kentdev/RGB-LEDs/README.md

# RGB-LEDs
Controls for a strip of Radioshack tricolor LEDs
