kentdev/RGB-LEDs/modeling/Control Board + Enclosure.fcstd

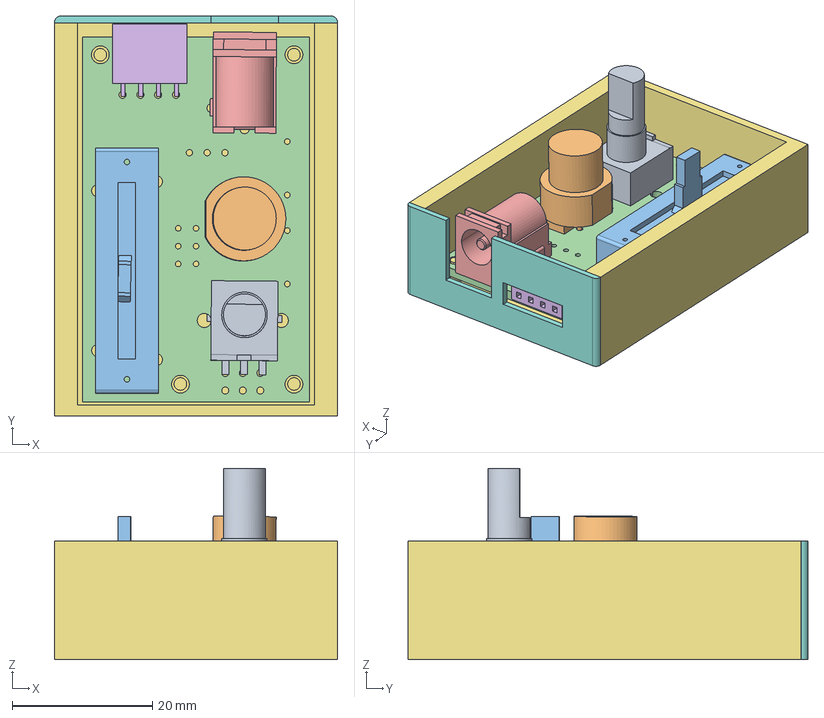
[picture p1: CAD file, 2015-12-07]
modeling/Control Board + Enclosure.fcstd
40.4 x 57.1 x 27.3 mm
Rotary
Button
Slide
Board_outline
PJ-202A
4-pin header
