kentdev/RGB-LEDs/modeling/4-pin header.fcstd

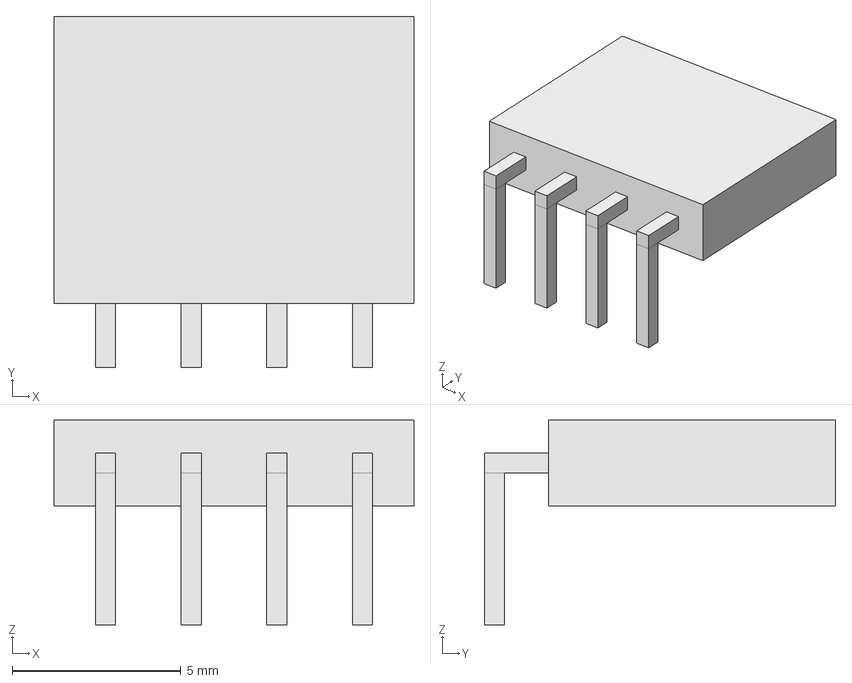
[picture p2: CAD file, 2015-09-26]
modeling/4-pin header.fcstd
10.7 x 10.4 x 6.07 mm
