kentdev/RGB-LEDs/modeling/Control board.fcstd

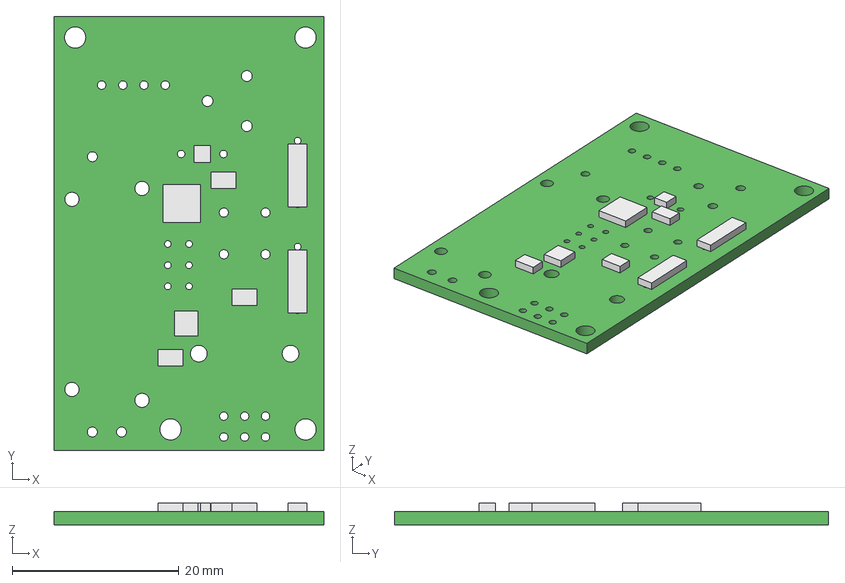
[picture p3: CAD file, 2015-09-26]
modeling/Control board.fcstd
32.4 x 52.1 x 2.60 mm
Board_outline
C1
C2
C3
IC2
R1
R3
REG1
RES1
