kentdev/RGB-LEDs/modeling/Controls.fcstd

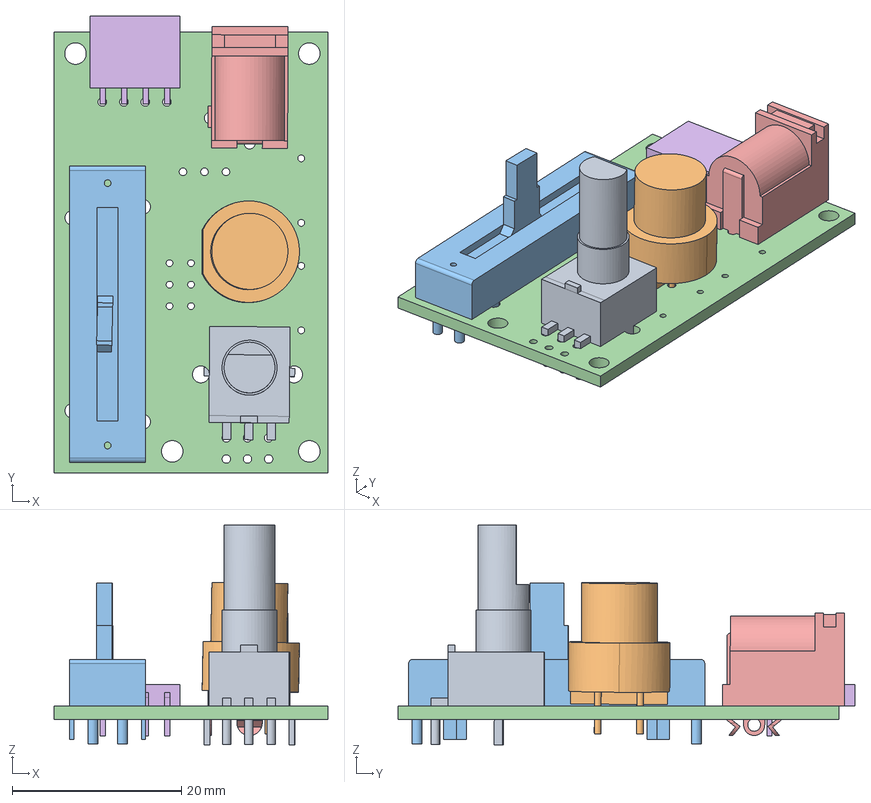
[picture p4: CAD file, 2015-09-26]
modeling/Controls.fcstd
32.4 x 53.9 x 26.0 mm
Rotary
Button
Slide
Board_outline
PJ-202A
4-pin header
