kentdev/RGB-LEDs/modeling/PJ-202A.stp

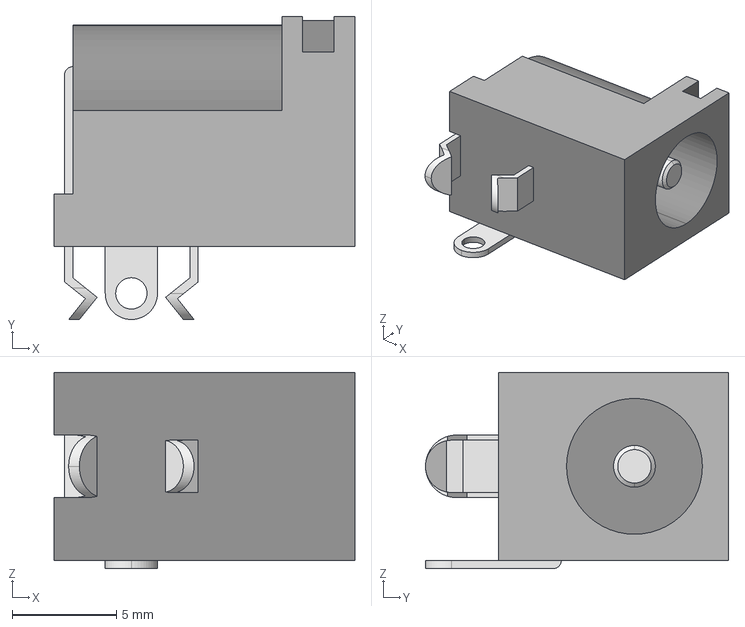
[picture p5: CAD file, 2015-09-26]
modeling/PJ-202A.stp
14.4 x 14.5 x 9.40 mm
