kentdev/RGB-LEDs/modeling/PTA2043 Linear Potentiometer.fcstd

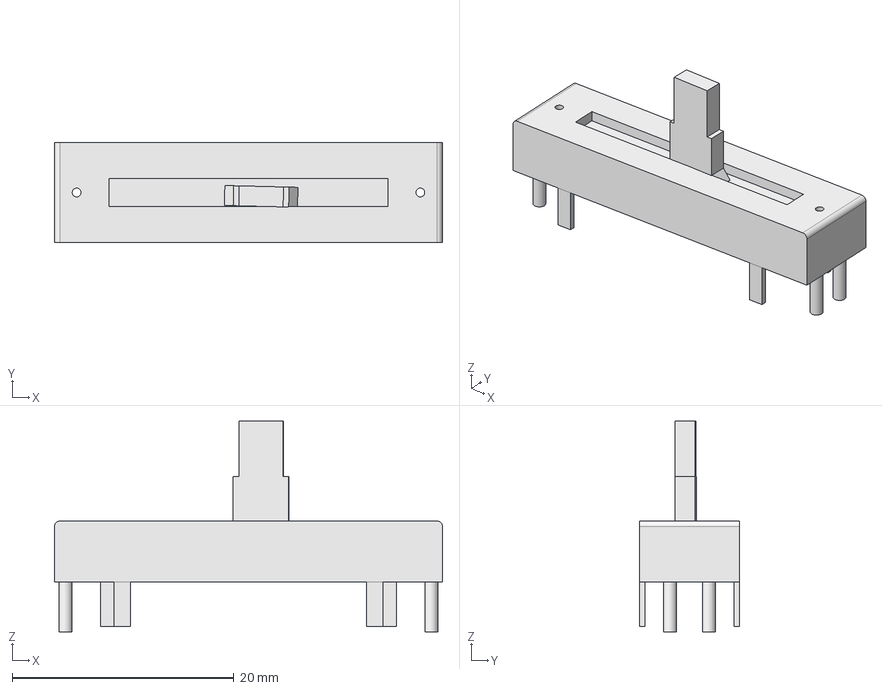
[picture p6: CAD file, 2015-08-29]
modeling/PTA2043 Linear Potentiometer.fcstd
35.0 x 9.00 x 19.0 mm
