kentdev/RGB-LEDs/modeling/PTA1543-2010CI slide potentiometer.fcstd

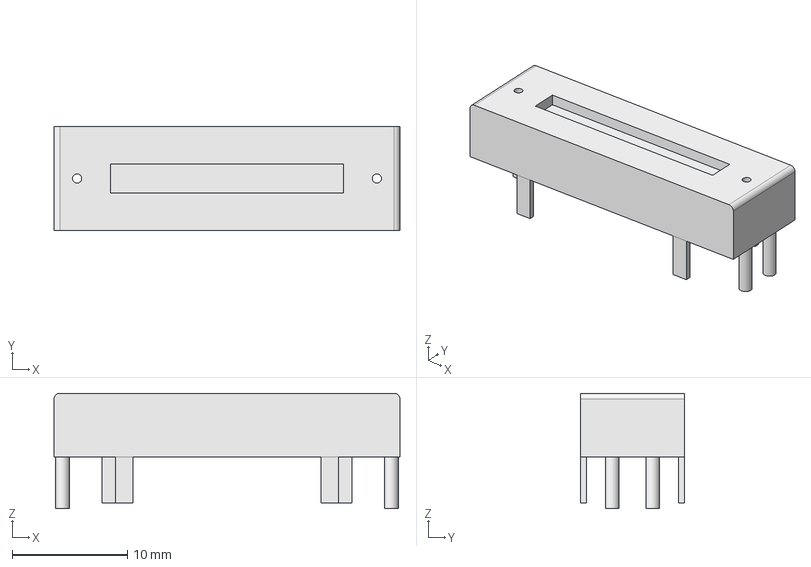
[picture p7: CAD file, 2015-08-29]
modeling/PTA1543-2010CI slide potentiometer.fcstd
30.0 x 9.00 x 10.0 mm
