kentdev/RGB-LEDs/modeling/PTA1543-2010CI Linear Potentiometer.fcstd

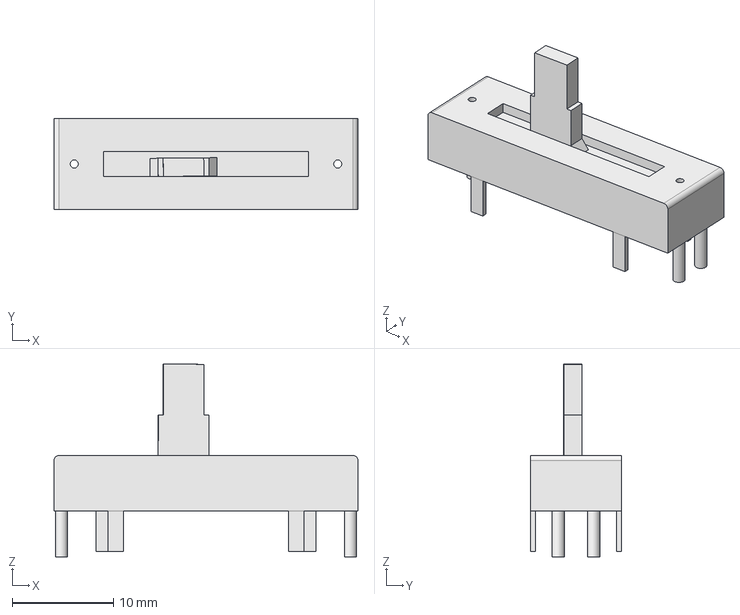
[picture p8: CAD file, 2015-08-29]
modeling/PTA1543-2010CI Linear Potentiometer.fcstd
30.0 x 9.00 x 19.0 mm
