kentdev/RGB-LEDs/modeling/LM7805c.fcstd

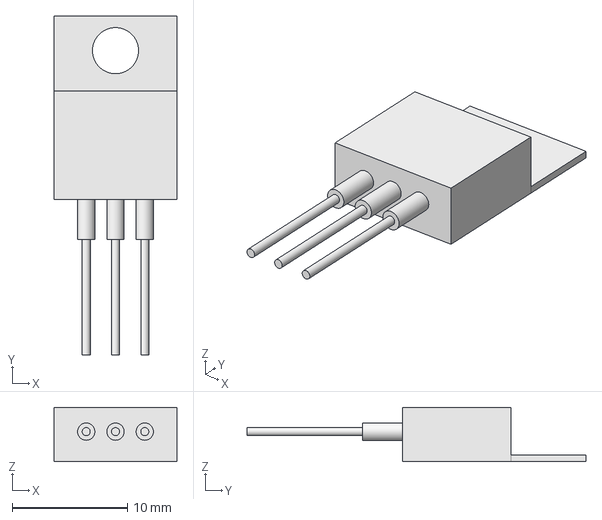
[picture p9: CAD file, 2015-08-29]
modeling/LM7805c.fcstd
10.7 x 29.4 x 4.70 mm
