kentdev/RGB-LEDs/modeling/PTA1543-2010CI slide lever.fcstd

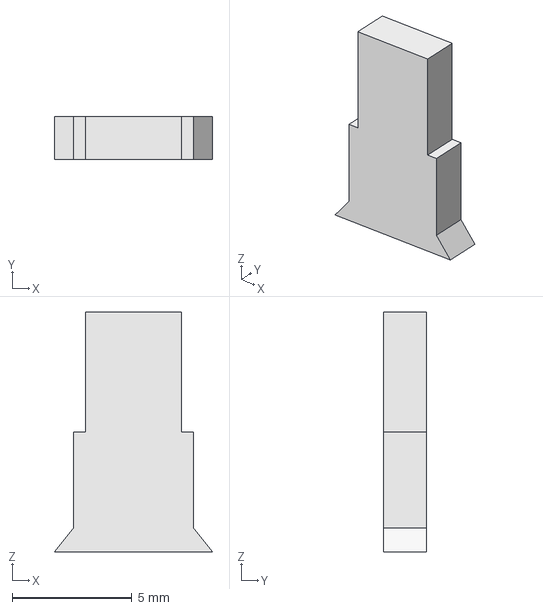
[picture p10: CAD file, 2015-08-23]
modeling/PTA1543-2010CI slide lever.fcstd
6.60 x 1.80 x 10.0 mm
