kentdev/RGB-LEDs/modeling/P0915N rotary potentiometer.fcstd

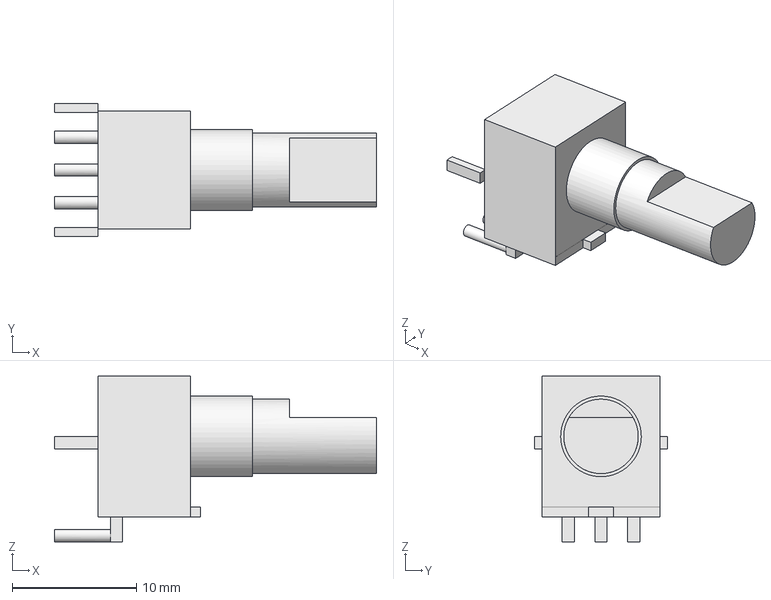
[picture p11: CAD file, 2015-08-23]
modeling/P0915N rotary potentiometer.fcstd
26.0 x 10.7 x 13.4 mm
