kentdev/RGB-LEDs/modeling/P09xP rotary potentiometer.fcstd

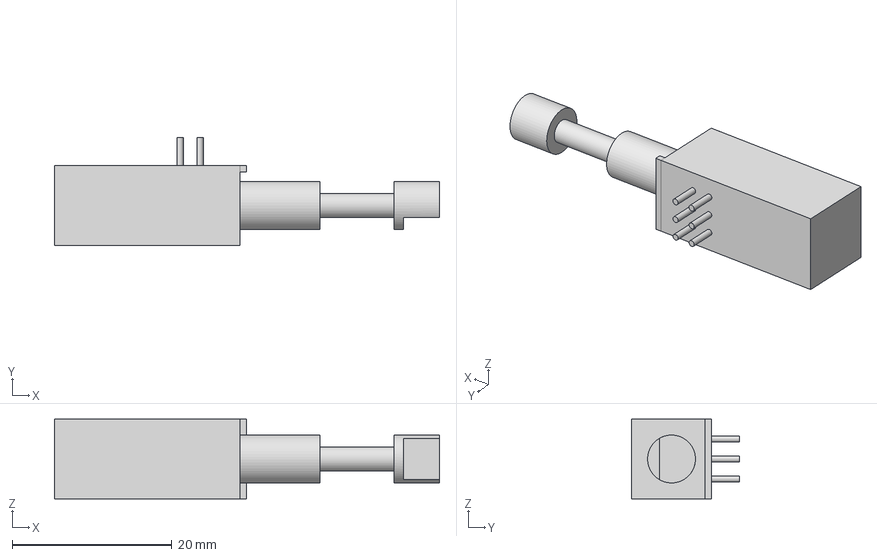
[picture p12: CAD file, 2015-08-23]
modeling/P09xP rotary potentiometer.fcstd
48.2 x 13.5 x 10.0 mm
