kentdev/RGB-LEDs/modeling/D6R00 pushbutton.fcstd

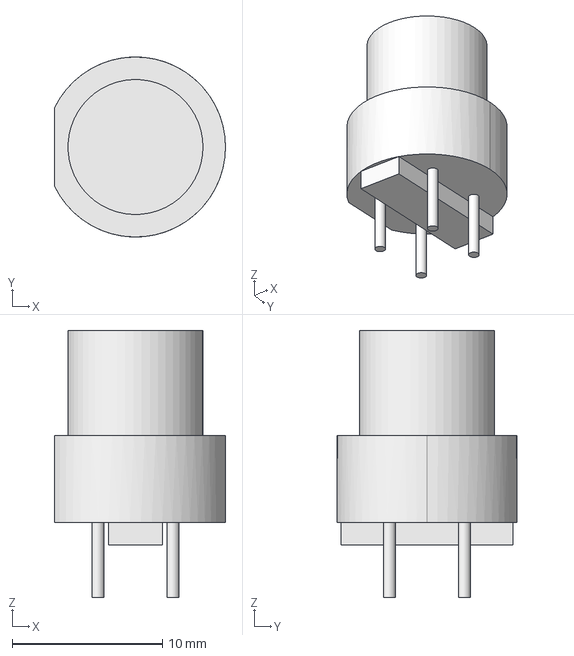
[picture p13: CAD file, 2015-08-23]
modeling/D6R00 pushbutton.fcstd
11.4 x 12.0 x 17.8 mm
