kentdev/RGB-LEDs/schematic/Control board.brd

## EAGLE design schematic/Control board.brd (2015-09-18)

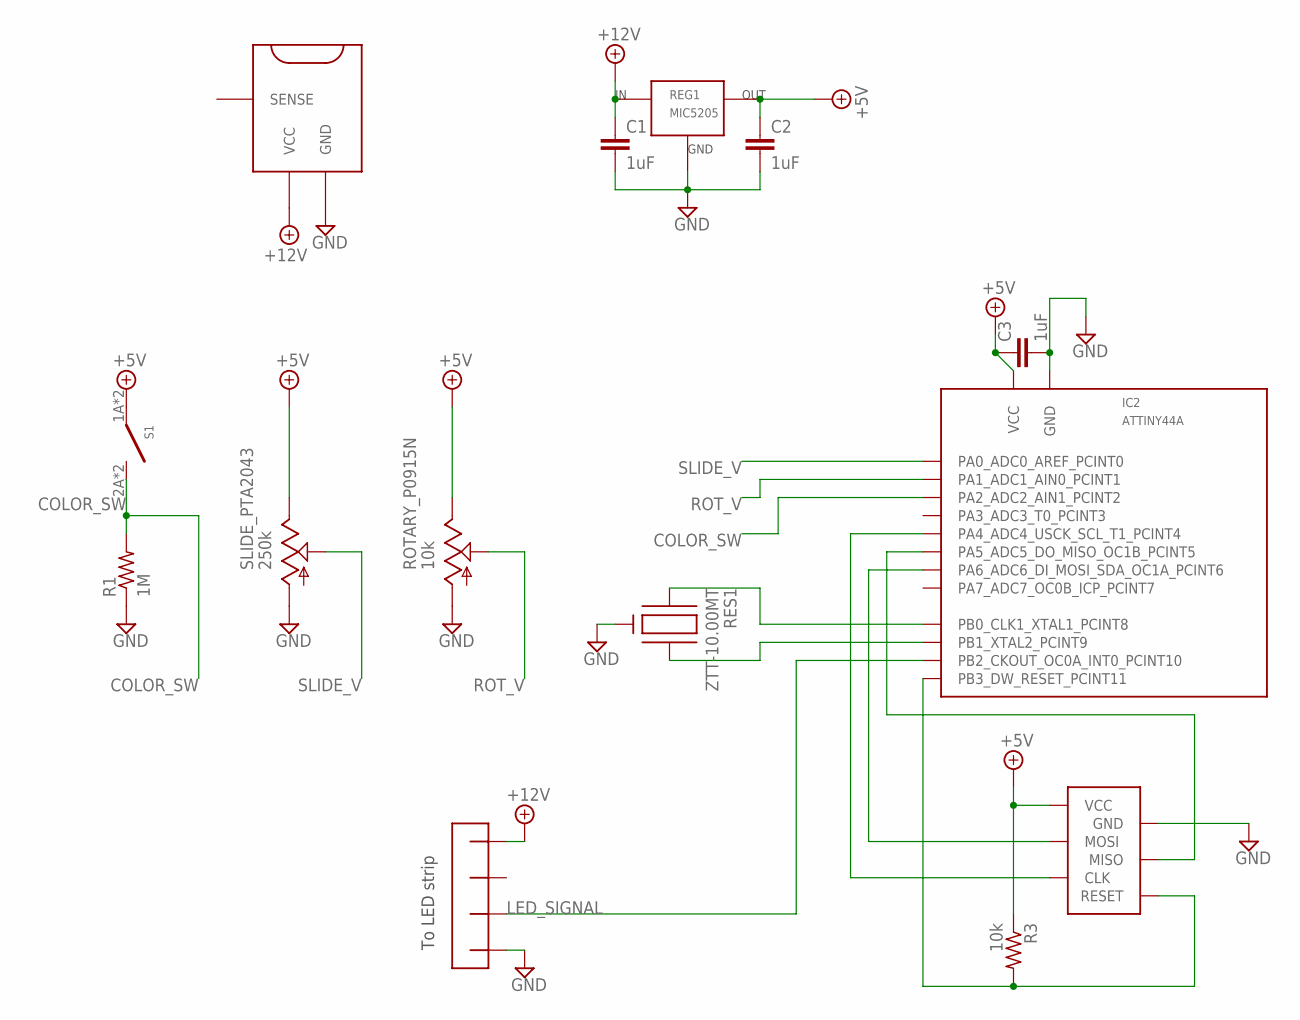
[picture p14: schematic Control board.sch]

Parts:
C1, C2, C3: 1uF; C0603
CONN1: 4-PIN-RIGHT-ANGLE; S5440
IC2: ATTINY44A; QFN-20
POW1: PJ-202A; PJ202A
R1: 1M; 0207/7
R3: 10k; 0207/7
REG1: MIC5205; SOT-23-5
RES1: ZTT-10.00MT; 3-PIN-THROUGH-HOLE
ROTARY_P0915N: 10k; P0915N
S1: D6R00
SLIDE_PTA2043: 250k; PTA2043
U$1: ISP

Connections:
+5V: C2.1, C3.1, IC2.P$9 (VCC), R3.1, REG1.5 (OUT), ROTARY_P0915N.R13 (B), S1.1A, S1.1B, SLIDE_PTA2043.P3 (B), U$1.VCC
+12V: C1.1, CONN1.P$4, POW1.1 (VCC), REG1.1 (IN), REG1.3 (IN)
COLOR_SW: IC2.P$3 (PA2_ADC2_AIN1_PCINT2), R1.2, S1.2A, S1.2B
GND: C1.2, C2.2, C3.2, CONN1.P$1, IC2.P$8 (GND), IC2.PAD (GND), POW1.2 (GND), R1.1, REG1.2 (GND), RES1.2 (GND), ROTARY_P0915N.R11 (A), SLIDE_PTA2043.P1 (A), U$1.GND
LED_SIGNAL: CONN1.P$2, IC2.P$14 (PB2_CKOUT_OC0A_INT0_PCINT10)
MISO: IC2.P$20 (PA5_ADC5_DO_MISO_OC1B_PCINT5), U$1.MISO
MOSI: IC2.P$16 (PA6_ADC6_DI_MOSI_SDA_OC1A_PCINT6), U$1.MOSI
unnamed: IC2.P$11 (PB0_CLK1_XTAL1_PCINT8), RES1.1 (X1)
unnamed: IC2.P$12 (PB1_XTAL2_PCINT9), RES1.3 (X2)
RESET: IC2.P$13 (PB3_DW_RESET_PCINT11), R3.2, U$1.RESET
ROT_V: IC2.P$4 (PA1_ADC1_AIN0_PCINT1), ROTARY_P0915N.R12 (S)
SCK: IC2.P$1 (PA4_ADC4_USCK_SCL_T1_PCINT4), U$1.SCK (CLK)
SLIDE_V: IC2.P$5 (PA0_ADC0_AREF_PCINT0), SLIDE_PTA2043.P2 (S)

Notes on the sheet:
To LED strip

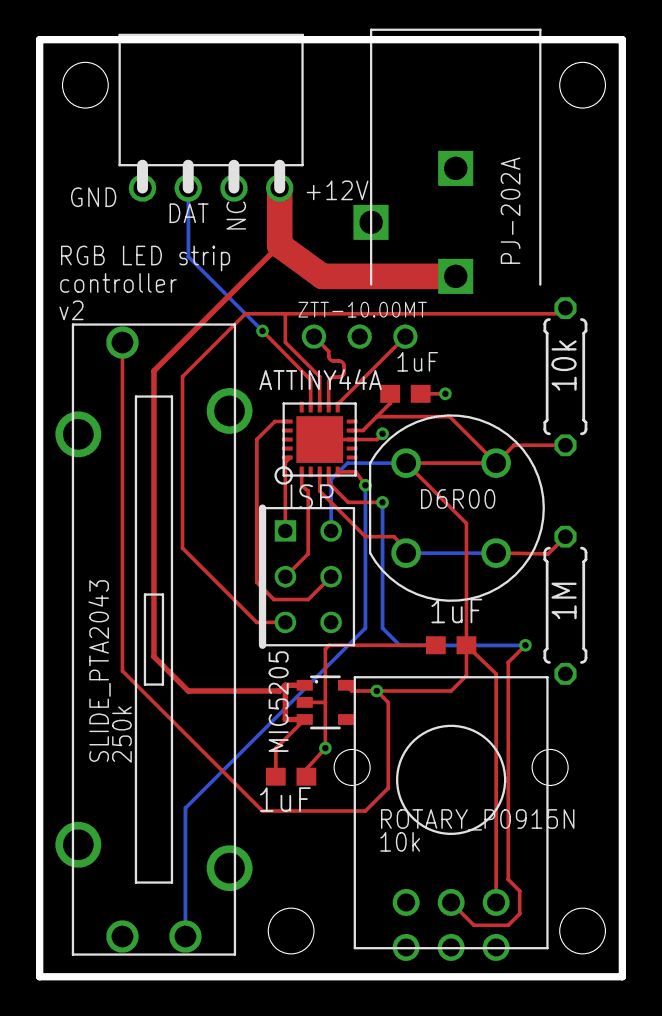
[picture p15: board Control board.brd from above]

Board: 2 copper layers, 32.4 x 52.1 mm, 14 parts (0 on the bottom side), 13 nets.
