kentdev/RGB-LEDs/(commit log)

2015-08-23 Updated .gitignore and added modeling and schematic directories
    [Control board.sch, Controls.fcstd, D6R00 pushbutton.fcstd, P0915N rotary potentiometer.fcstd, P09xP rotary potentiometer.fcstd, PTA1543-2010CI Linear Potentiometer.fcstd, PTA1543-2010CI slide lever.fcstd, PTA1543-2010CI slide potentiometer.fcstd]
2015-08-28 Added more library components and updated the board design
    [Control board.brd, Control board.sch]
2015-08-29 Updated schematic, board file, and library; also updated the 3D model
    [Control board.brd, Control board.fcstd, Control board.sch, Controls.fcstd, LM7805c.fcstd, PTA1543-2010CI Linear Potentiometer.fcstd, PTA1543-2010CI slide potentiometer.fcstd, PTA2043 Linear Potentiometer.fcstd]
2015-08-29 Voltage regulator and DIP microcontroller are too big, replacing with small SMD components
    [Control board.brd, Control board.sch]
2015-08-30 Updated board with QFN-20 microcontroller
    [Control board.brd, Control board.sch]
2015-08-30 Made the circuit board more compact
    [Control board.brd]
2015-08-30 Added a title to the board
    [Control board.brd]
2015-08-30 Fixed value layers and line widths
    [Control board.brd]
2015-09-01 Changed the resonator value from 16Mhz to 10MHz, for more accurate LED timing
    [Control board.brd, Control board.sch]
2015-09-03 Began writing the code to read the controls and send commands to the LED strip
2015-09-06 Fixed LED port and improved sendToLED timings
    [main.h, sendToLED.c]
2015-09-06 More progress accommodating the RGB LED strip timings, by squeezing the assembly code for every last cycle
2015-09-07 Added code to create a demo color wheel effect across the LEDs
2015-09-07 Fixed the bounding area of the potentiometer, and adjusted the value of the reset line's pull-up resistor
    [Control board.brd, Control board.sch]
2015-09-13 Added #ifdef to switch between color demo and regular operation
2015-09-16 Barrel jack holes were way too big, fixed
    [Control board.brd, Control board.sch]
2015-09-16 Fixed wrong outline of vertical rotary potentiometer
    [Control board.brd, Control board.sch]
2015-09-17 Made the board a bit smaller, but there's still room to shrink it more
    [Control board.brd, Control board.sch]
2015-09-18 Reduced the size of the control board
    [Control board.brd]
2015-09-18 Straightened a wire
    [Control board.brd]
2015-09-26 Added downloaded PJ-202A 3D model from Cui, Inc.
    [PJ-202A.stp]
2015-09-26 Added the pin header to the board; board now has all relevant components attached
    [4-pin header.fcstd, Control board.fcstd, Controls.fcstd]
2015-10-25 Added low-pass filtering to the slide potentiometer input
2015-11-10 Finished second draft of enclosure, now with face and separate top plate
    [Control Board + Enclosure.fcstd]
2015-12-07 Working v1 enclosure
    [Control Board + Enclosure.fcstd]
2015-12-07 Added code to balance the color coming the RGB LEDs, for a better white
2015-12-07 Added automatic shutdown if the LEDs have been left on without having their brightness changed for over 2 hours
2016-02-02 Reworked the main loop and made ADC use an interrupt
    [main.c, main.h]
2016-02-11 Fixed port assignments, updated dead band code, reduced change deltas
    [main.c, main.h]
2016-02-12 Added the beginnings of a low-power mode
2016-02-13 Fixed color demo artifacting
    [main.c]
2016-02-14 Removed the color demo mode compilation switch, and instead made it activate if the color mode button is held for ~4 seconds before being released
